rrowniak/impedance_meter/README.md

# Impedance Meter - a tool for measuring input and output impedance

## Details
More details coming soon, check out my [blog](http://rrowniak.com)

## Author

Rafal Rowniak

## License

GPL-3.0 for non commercial use cases

For commercial use cases please contact the author.
