rrowniak/impedance_meter/imp_meter.kicad_pcb

## KiCad design imp_meter.kicad_pcb (2018-12-02)

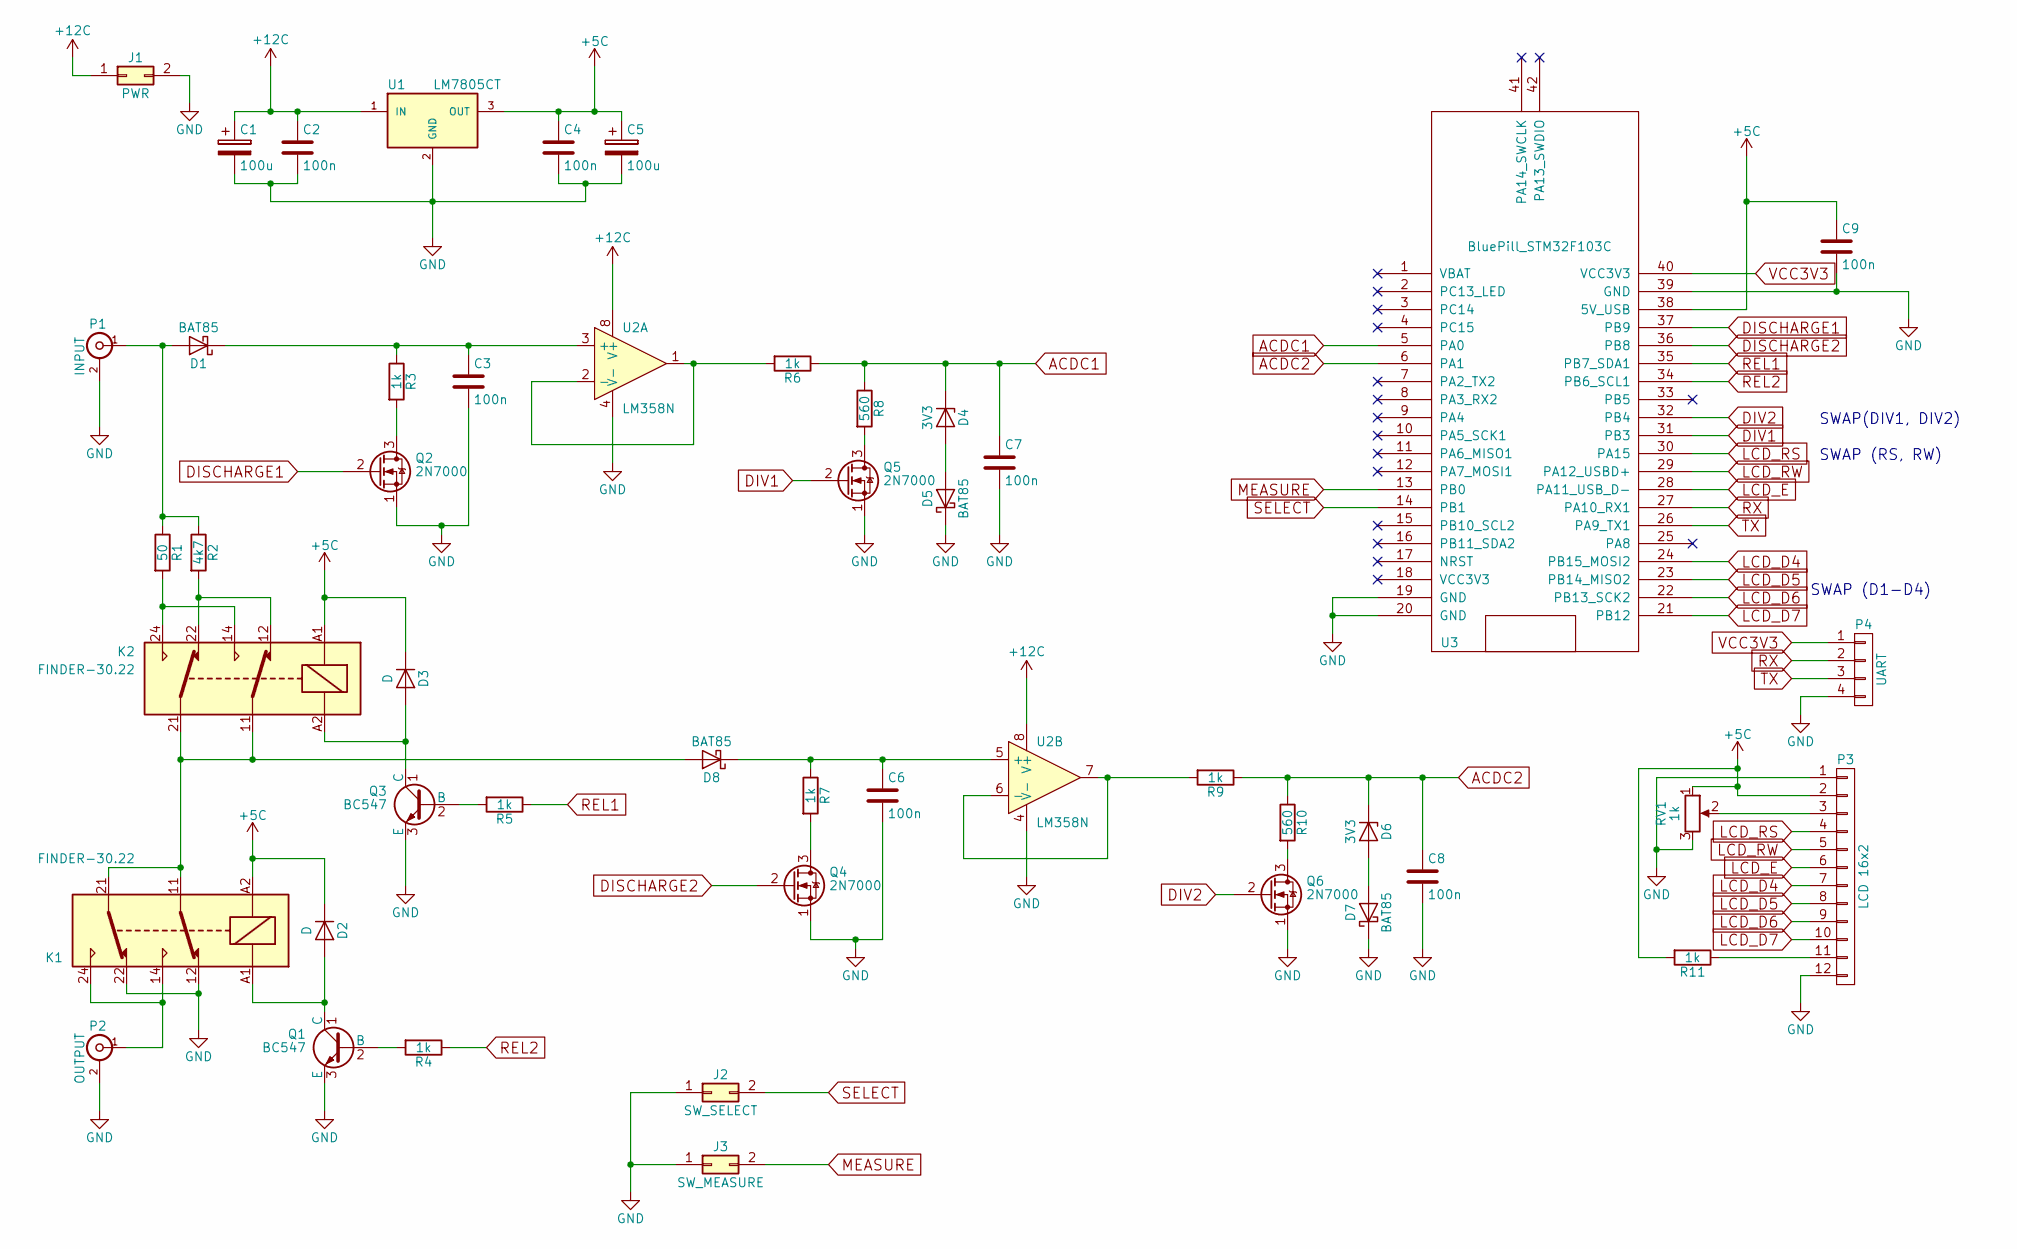
[picture p3: schematic imp_meter.sch]

Parts:
C1, C5: 100u; CP_Radial_D8.0mm_P5.00mm
C2, C3, C4, C6, C7, C8, C9: 100n; C_Disc_D3_P2.5
D1, D5, D7, D8: BAT85; D_A-405_P7.62mm_Horizontal
D2, D3: D; D_A-405_P7.62mm_Horizontal
D4, D6: 3V3; D_A-405_P7.62mm_Horizontal
J1: PWR; Pin_Header_Straight_2x01
J2: SW_SELECT; Pin_Header_Straight_2x01
J3: SW_MEASURE; Pin_Header_Straight_2x01
K1, K2: FINDER-30.22; Relay_DPDT_Finder_30.22
P1: INPUT; bnc-ci
P2: OUTPUT; bnc-ci
P3: LCD 16x2; Pin_Header_Straight_1x12
P4: UART; Pin_Header_Straight_1x04
Q1, Q3: BC547
Q2, Q4, Q5, Q6: 2N7000; TO-92_Molded_Narrow_Oval
R1: 50; R_Axial_DIN0411_L9.9mm_D3.6mm_P15.24mm_Horizontal
R2: 4k7; R_Axial_DIN0207_L6.3mm_D2.5mm_P10.16mm_Horizontal
R3, R4, R5, R6, R7, R9, R11: 1k; R_Axial_DIN0207_L6.3mm_D2.5mm_P10.16mm_Horizontal
R8, R10: 560; R_Axial_DIN0207_L6.3mm_D2.5mm_P10.16mm_Horizontal
RV1: 1k; Potentiometer_ACP_CA9-V10_Vertical
U1: LM7805CT; TO-220
U2: LM358N; DIP-8_W7.62mm_LongPads
U3: BluePill_STM32F103C

Connections:
+5C: C4.1, C5.1, C9.1, D2.1 (K), D3.1 (K), K1.A2, K2.A1, P3.2, R11.2, RV1.1, U1.3 (OUT), U3.38 (5V_USB)
+12C: C1.1, C2.1, J1.1, U1.1 (IN), U2.8 (V+)
ACDC1: C7.1, D4.1 (K), R6.1, R8.1, U3.5 (PA0)
ACDC2: C8.1, D6.1 (K), R9.1, R10.1, U3.6 (PA1)
DISCHARGE1: Q2.2 (G), U3.37 (PB9)
DISCHARGE2: Q4.2 (G), U3.36 (PB8)
DIV1: Q5.2 (G), U3.31 (PB3)
DIV2: Q6.2 (G), U3.32 (PB4)
GND: C1.2, C2.2, C3.2, C4.2, C5.2, C6.2, C7.2, C8.2, C9.2, D5.1 (K), D7.1 (K), J1.2, J2.1, J3.1, K1.12, K1.22, P1.2 (Ext), P2.2 (Ext), P3.1, P3.12, P4.4, Q1.3 (E), Q2.1 (S), Q3.3 (E), Q4.1 (S), Q5.1 (S), Q6.1 (S), RV1.3, U1.2 (GND), U2.4 (V-), U3.19 (GND), U3.20 (GND), U3.39 (GND)
LCD_D4: P3.7, U3.24 (PB15_MOSI2)
LCD_D5: P3.8, U3.23 (PB14_MISO2)
LCD_D6: P3.9, U3.22 (PB13_SCK2)
LCD_D7: P3.10, U3.21 (PB12)
LCD_E: P3.6, U3.28 (PA11_USB_D-)
LCD_RS: P3.4, U3.30 (PA15)
LCD_RW: P3.5, U3.29 (PA12_USBD+)
MEASURE: J3.2, U3.13 (PB0)
unnamed: C3.1, D1.1 (K), R3.1, U2.3 (+)
unnamed: D1.2 (A), P1.1 (In), R1.1, R2.1
unnamed: D2.2 (A), K1.A1, Q1.1 (C)
unnamed: D3.2 (A), K2.A2, Q3.1 (C)
unnamed: D4.2 (A), D5.2 (A)
unnamed: D6.2 (A), D7.2 (A)
unnamed: K1.14, K1.24, P2.1 (In)
unnamed: K2.12, K2.22, R2.2
unnamed: K2.14, K2.24, R1.2
unnamed: P3.3, RV1.2
unnamed: P3.11, R11.1
unnamed: Q1.2 (B), R4.2
unnamed: Q2.3 (D), R3.2
unnamed: Q3.2 (B), R5.2
unnamed: Q4.3 (D), R7.2
unnamed: Q5.3 (D), R8.2
unnamed: Q6.3 (D), R10.2
unnamed: R6.2, U2.1, U2.2 (-)
unnamed: R9.2, U2.6 (-), U2.7
REL1: R5.1, U3.35 (PB7_SDA1)
REL2: R4.1, U3.34 (PB6_SCL1)
RX: P4.2, U3.27 (PA10_RX1)
SELECT: J2.2, U3.14 (PB1)
TX: P4.3, U3.26 (PA9_TX1)
VCC3V3: P4.1, U3.40 (VCC3V3)

Notes on the sheet:
SWAP (RS, RW)
SWAP (D1-D4)
SWAP(DIV1, DIV2)

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
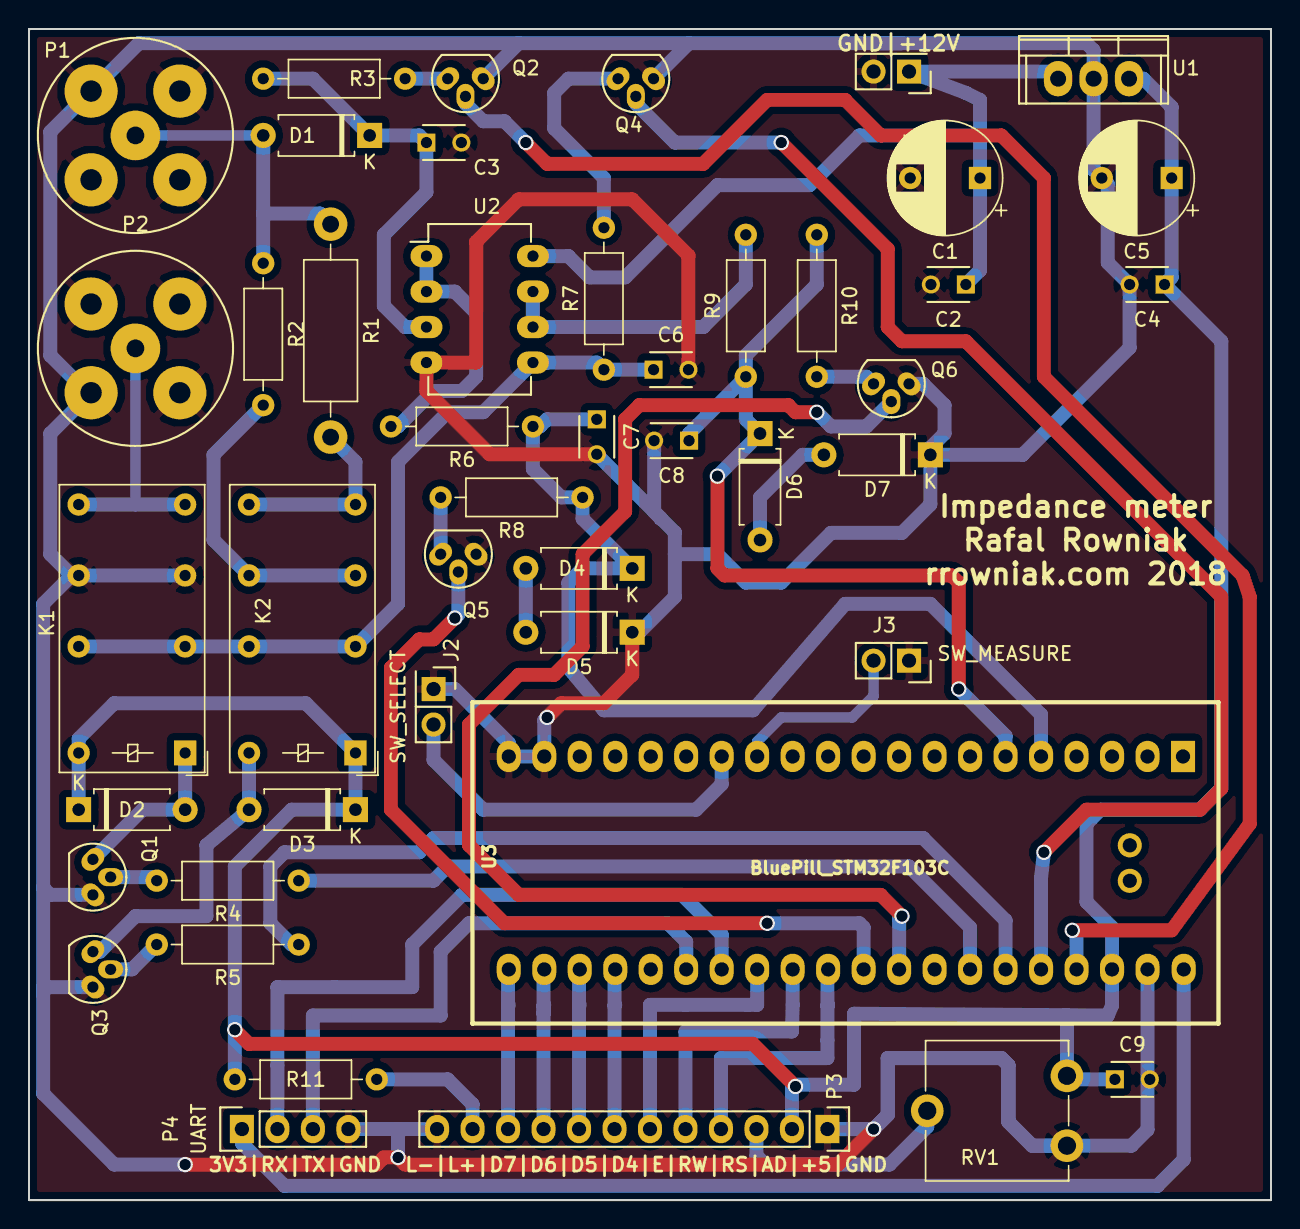
[picture p4: board imp_meter.kicad_pcb from above]

Board: 2 copper layers, 88.9 x 83.8 mm, 46 parts (0 on the bottom side), 43 nets.
