rrowniak/impedance_meter/firmware/impedance_meter.ioc

Mcu.UserName=STM32F103C8Tx
PA0-WKUP.Signal=ADCx_IN0
PA1.Signal=ADCx_IN1
PA11.GPIO_Label=LCD_PIN_E
PA11.Signal=GPIO_Output
PA12.GPIO_Label=LCD_PIN_RW
PA12.Signal=GPIO_Output
PA15.GPIO_Label=LCD_PIN_RS
PA15.Signal=GPIO_Output
PB0.GPIO_Label=MEASURE
PB0.Signal=GPIO_Input
PB1.GPIO_Label=SEL_MODE
PB1.Signal=GPIO_Input
PB12.GPIO_Label=LCD_PIN_D7
PB12.Signal=GPIO_Output
PB13.GPIO_Label=LCD_PIN_D6
PB13.Signal=GPIO_Output
PB14.GPIO_Label=LCD_PIN_D5
PB14.Signal=GPIO_Output
PB15.GPIO_Label=LCD_PIN_D4
PB15.Signal=GPIO_Output
PB3.GPIO_Label=DIV_1
PB3.Signal=GPIO_Output
PB4.GPIO_Label=DIV_2
PB4.Signal=GPIO_Output
PB6.GPIO_Label=REL_2
PB6.Signal=GPIO_Output
PB7.GPIO_Label=REL_1
PB7.Signal=GPIO_Output
PB8.GPIO_Label=DISCHARGE_2
PB8.Signal=GPIO_Output
PB9.GPIO_Label=DISCHARGE_1
PB9.Signal=GPIO_Output
PC13-TAMPER-RTC.GPIO_Label=CTRL_LED
PC13-TAMPER-RTC.Signal=GPIO_Output
PD0-OSC_IN.Signal=RCC_OSC_IN
PD1-OSC_OUT.Signal=RCC_OSC_OUT
