rrowniak/impedance_meter/firmware/Inc/main.h

#define CTRL_LED_Pin GPIO_PIN_13
#define CTRL_LED_GPIO_Port GPIOC
#define MEASURE_Pin GPIO_PIN_0
#define MEASURE_GPIO_Port GPIOB
#define SEL_MODE_Pin GPIO_PIN_1
#define SEL_MODE_GPIO_Port GPIOB
#define LCD_PIN_D7_Pin GPIO_PIN_12
#define LCD_PIN_D7_GPIO_Port GPIOB
#define LCD_PIN_D6_Pin GPIO_PIN_13
#define LCD_PIN_D6_GPIO_Port GPIOB
#define LCD_PIN_D5_Pin GPIO_PIN_14
#define LCD_PIN_D5_GPIO_Port GPIOB
#define LCD_PIN_D4_Pin GPIO_PIN_15
#define LCD_PIN_D4_GPIO_Port GPIOB
#define LCD_PIN_E_Pin GPIO_PIN_11
#define LCD_PIN_E_GPIO_Port GPIOA
#define LCD_PIN_RW_Pin GPIO_PIN_12
#define LCD_PIN_RW_GPIO_Port GPIOA
#define LCD_PIN_RS_Pin GPIO_PIN_15
#define LCD_PIN_RS_GPIO_Port GPIOA
#define DIV_1_Pin GPIO_PIN_3
#define DIV_1_GPIO_Port GPIOB
#define DIV_2_Pin GPIO_PIN_4
#define DIV_2_GPIO_Port GPIOB
#define REL_2_Pin GPIO_PIN_6
#define REL_2_GPIO_Port GPIOB
#define REL_1_Pin GPIO_PIN_7
#define REL_1_GPIO_Port GPIOB
#define DISCHARGE_2_Pin GPIO_PIN_8
#define DISCHARGE_2_GPIO_Port GPIOB
#define DISCHARGE_1_Pin GPIO_PIN_9
#define DISCHARGE_1_GPIO_Port GPIOB
