rrowniak/impedance_meter/firmware/Inc/error_compensation.h

#ifndef __error_correction_H
#define __error_correction_H
#ifdef __cplusplus
extern "C" {
#endif

#define MEASURE_ERROR_COMPENSATION 1

float correct_voltage(float input_v);

#ifdef __cplusplus
}
#endif
#endif
