rrowniak/impedance_meter/firmware/Inc/error_correction.h

#ifndef __error_correction_H
#define __error_correction_H
#ifdef __cplusplus
extern "C" {
#endif

#define MEASURE_ERROR_CORRECTION 1

float correct_voltage(float input_v);

#ifdef __cplusplus
}
#endif
#endif
