rrowniak/impedance_meter/(commit log)

2018-06-24 Fixed shunt resistor value
    [measure.h]
2018-06-27 Some bugs related to measurements fixed
    [measure.c]
2018-07-01 Fixed several bugs related to Input imp measurement
    [adc.c, impedance_meter.ioc, measure.c, measure.h]
2018-07-12 Added error correction based on linear interpolation
    [error_correction.c, error_correction.h, logic.c, measure.c, measure.h]
2018-12-02 Added PCB project
    [imp_meter-B.Cu.gbr, imp_meter-B.Mask.gbr, imp_meter-B.SilkS.gbr, imp_meter-Edge.Cuts.gbr, imp_meter-F.Cu.gbr, imp_meter-F.Mask.gbr, imp_meter-F.SilkS.gbr, imp_meter.drl]
